DONGKHOA/SMART_LED_CONTROL/Hardware/BTL_ESD/BTL_ESD.kicad_pcb

## KiCad design Hardware/BTL_ESD/BTL_ESD.kicad_pcb (2024-05-07)

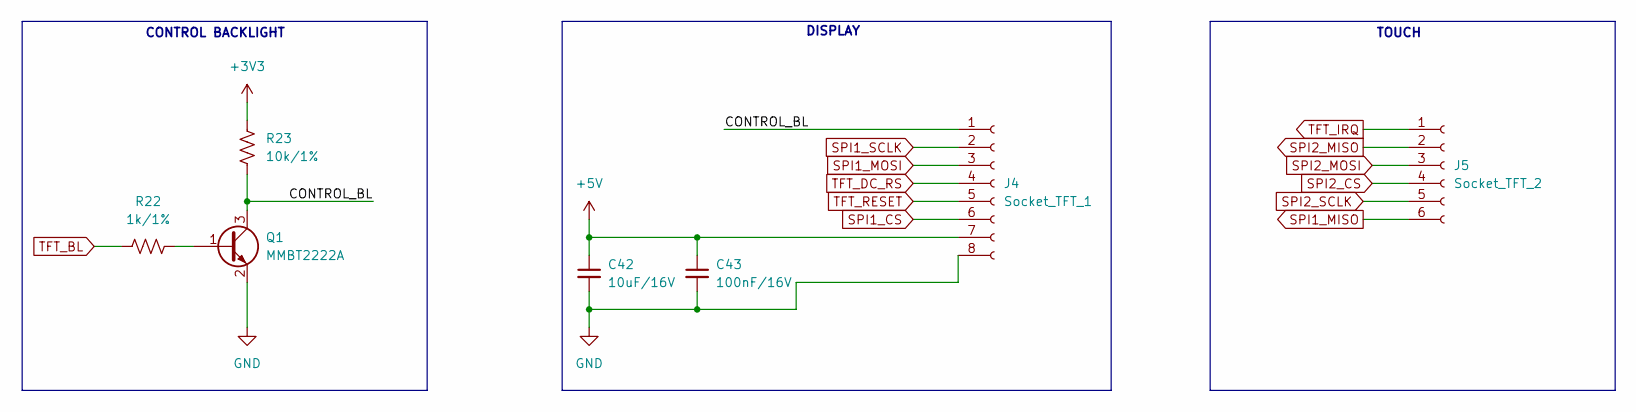
[picture p1: schematic tft.kicad_sch, ILI9341]

Parts:
C42: 10uF/16V; C_0603_1608Metric_Pad1.08x0.95mm_HandSolder
C43: 100nF/16V; C_0603_1608Metric_Pad1.08x0.95mm_HandSolder
J4: Socket_TFT_1; au_XH_2.54mm_8_Chan_Dan_SMD_Nam_Ngang
J5: Socket_TFT_2; au_XH_2.54mm_6_Chan_Dan_SMD_Nam_Ngang
Q1: MMBT2222A; SOT103P240X110-3N
R22: 1k/1%; R_0603_1608Metric_Pad0.98x0.95mm_HandSolder
R23: 10k/1%; R_0603_1608Metric_Pad0.98x0.95mm_HandSolder

Connections:
+3V3: R23.1; also elsewhere on the board
+5V: C42.1, C43.1, J4.7; also elsewhere on the board
/TFT/CONTROL_BL: J4.1, Q1.3, R23.2
GND: C42.2, C43.2, J4.8, Q1.2; also elsewhere on the board
unnamed: Q1.1, R22.2
SPI1_CS: J4.6; also elsewhere on the board
SPI1_MISO: J5.6; also elsewhere on the board
SPI1_MOSI: J4.3; also elsewhere on the board
SPI1_SCLK: J4.2; also elsewhere on the board
SPI2_CS: J5.4; also elsewhere on the board
SPI2_MISO: J5.2; also elsewhere on the board
SPI2_MOSI: J5.3; also elsewhere on the board
SPI2_SCLK: J5.5; also elsewhere on the board
TFT_BL: R22.1; also elsewhere on the board
TFT_DC_RS: J4.4; also elsewhere on the board
TFT_IRQ: J5.1; also elsewhere on the board
TFT_RESET: J4.5; also elsewhere on the board

Notes on the sheet:
TOUCH
DISPLAY
CONTROL BACKLIGHT

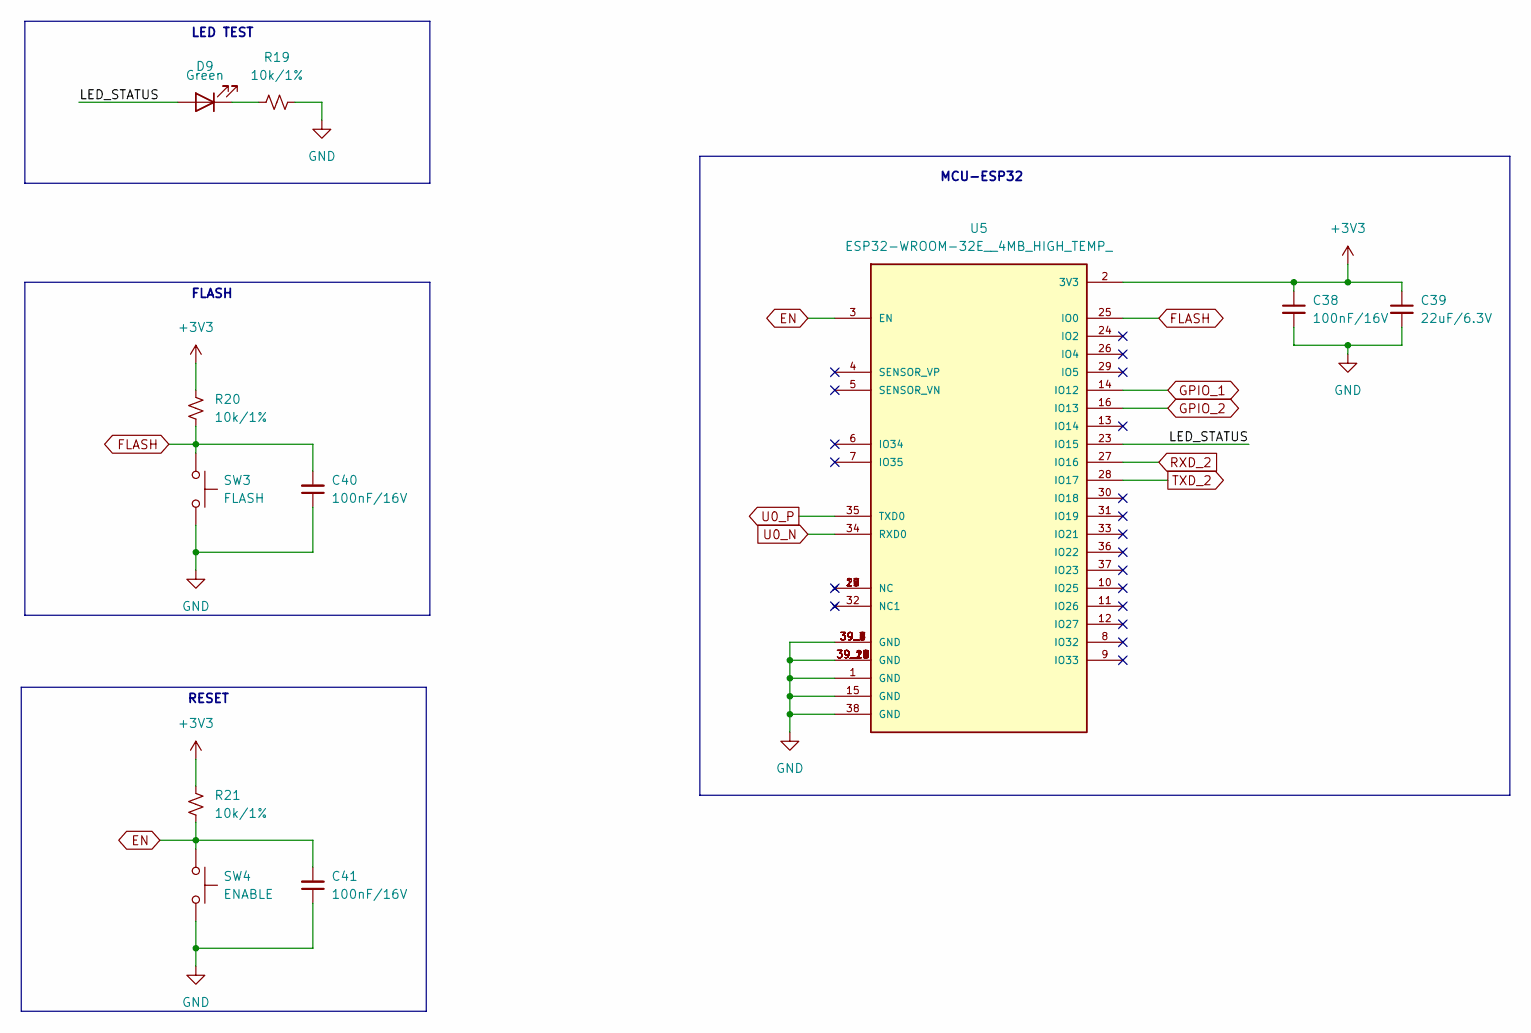
[picture p2: schematic esp32.kicad_sch]

Parts:
C38, C40, C41: 100nF/16V; C_0603_1608Metric_Pad1.08x0.95mm_HandSolder
C39: 22uF/6.3V; C_0603_1608Metric_Pad1.08x0.95mm_HandSolder
D9: Green; LED_0805_2012Metric_Pad1.15x1.40mm_HandSolder
R19, R20, R21: 10k/1%; R_0603_1608Metric_Pad0.98x0.95mm_HandSolder
SW3: FLASH; SW_SPST_B3U-1000P
SW4: ENABLE; SW_SPST_B3U-1000P
U5: ESP32-WROOM-32E__4MB_HIGH_TEMP_; XCVR_ESP32-WROOM-32E__4MB_HIGH_TEMP_

Connections:
+3V3: C38.1, C39.1, R20.1, R21.1, U5.2 (3V3); also elsewhere on the board
/ESP32/LED_STATUS: D9.2 (A), U5.23 (IO15)
EN: C41.2, R21.2, SW4.1, U5.3 (EN); also elsewhere on the board
FLASH: C40.2, R20.2, SW3.1, U5.25 (IO0); also elsewhere on the board
GND: C38.2, C39.2, C40.1, C41.1, R19.2, SW3.2, SW4.2, U5.1 (GND), U5.15 (GND), U5.38 (GND), U5.39_1 (GND), U5.39_2 (GND), U5.39_3 (GND), U5.39_4 (GND), U5.39_5 (GND), U5.39_6 (GND), U5.39_7 (GND), U5.39_8 (GND), U5.39_9 (GND), U5.39_10 (GND), U5.39_11 (GND), U5.39_12 (GND), U5.39_13 (GND), U5.39_14 (GND), U5.39_15 (GND), U5.39_16 (GND), U5.39_17 (GND), U5.39_18 (GND), U5.39_19 (GND), U5.39_20 (GND), U5.39_21 (GND); also elsewhere on the board
GPIO_1: U5.14 (IO12); also elsewhere on the board
GPIO_2: U5.16 (IO13); also elsewhere on the board
unnamed: D9.1 (K), R19.1
RXD_2: U5.27 (IO16); also elsewhere on the board
TXD_2: U5.28 (IO17); also elsewhere on the board
U0_N: U5.34 (RXD0); also elsewhere on the board
U0_P: U5.35 (TXD0); also elsewhere on the board

Notes on the sheet:
MCU-ESP32
LED TEST
RESET
FLASH

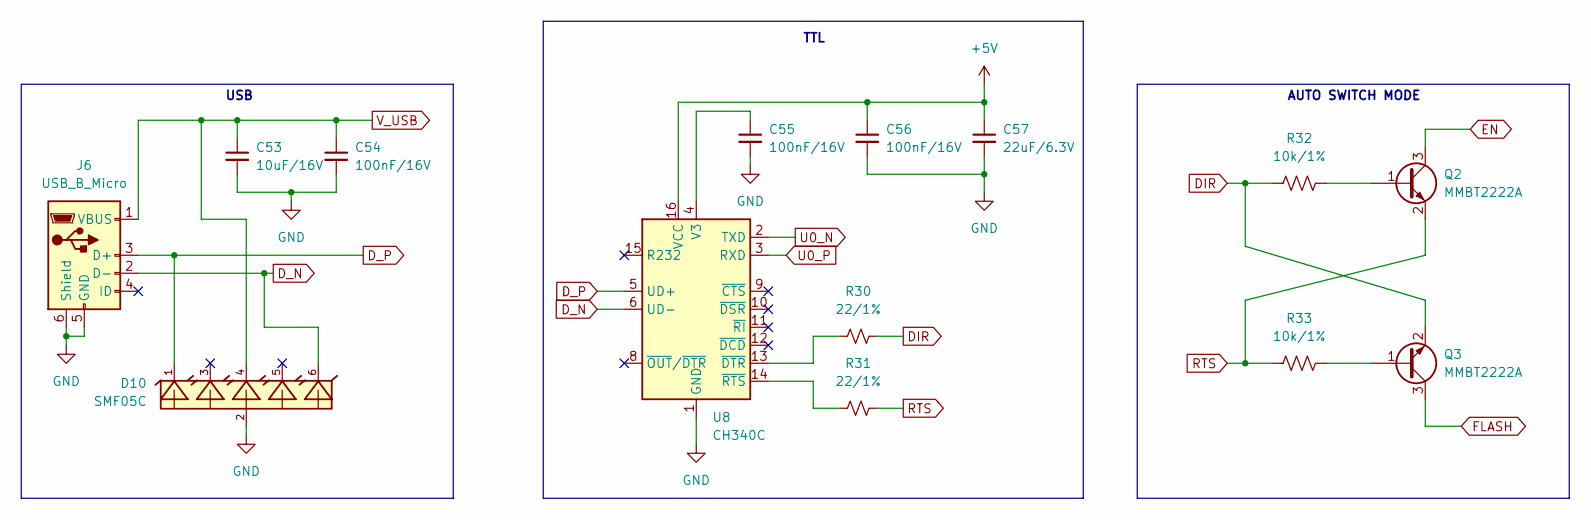
[picture p3: schematic USB_TTL.kicad_sch]

Parts:
C53: 10uF/16V; C_0603_1608Metric_Pad1.08x0.95mm_HandSolder
C54, C55, C56: 100nF/16V; C_0603_1608Metric_Pad1.08x0.95mm_HandSolder
C57: 22uF/6.3V; C_0603_1608Metric_Pad1.08x0.95mm_HandSolder
D10: SMF05C; SC70-6
J6: USB_B_Micro; USB_Micro-B_Wuerth_629105150521
Q2, Q3: MMBT2222A; SOT103P240X110-3N
R30, R31: 22/1%; R_0603_1608Metric_Pad0.98x0.95mm_HandSolder
R32, R33: 10k/1%; R_0603_1608Metric_Pad0.98x0.95mm_HandSolder
U8: CH340C; SOIC-16_3.9x9.9mm_P1.27mm

Connections:
+5V: C56.1, C57.1, U8.16 (VCC); also elsewhere on the board
DIR: Q3.2, R30.2, R32.1
D_N: D10.6, J6.2 (D-), U8.6 (UD-)
D_P: D10.1, J6.3 (D+), U8.5 (UD+)
EN: Q2.3; also elsewhere on the board
FLASH: Q3.3; also elsewhere on the board
GND: C53.2, C54.2, C55.2, C56.2, C57.2, D10.2, J6.5 (GND), J6.6 (Shield), U8.1 (GND); also elsewhere on the board
unnamed: Q2.1, R32.2
unnamed: Q3.1, R33.2
unnamed: C55.1, U8.4 (V3)
unnamed: R30.1, U8.13 (~DTR)
unnamed: R31.1, U8.14 (~RTS)
RTS: Q2.2, R31.2, R33.1
U0_N: U8.2 (TXD); also elsewhere on the board
U0_P: U8.3 (RXD); also elsewhere on the board
V_USB: C53.1, C54.1, D10.4, J6.1 (VBUS); also elsewhere on the board

Notes on the sheet:
TTL
AUTO SWITCH MODE
USB

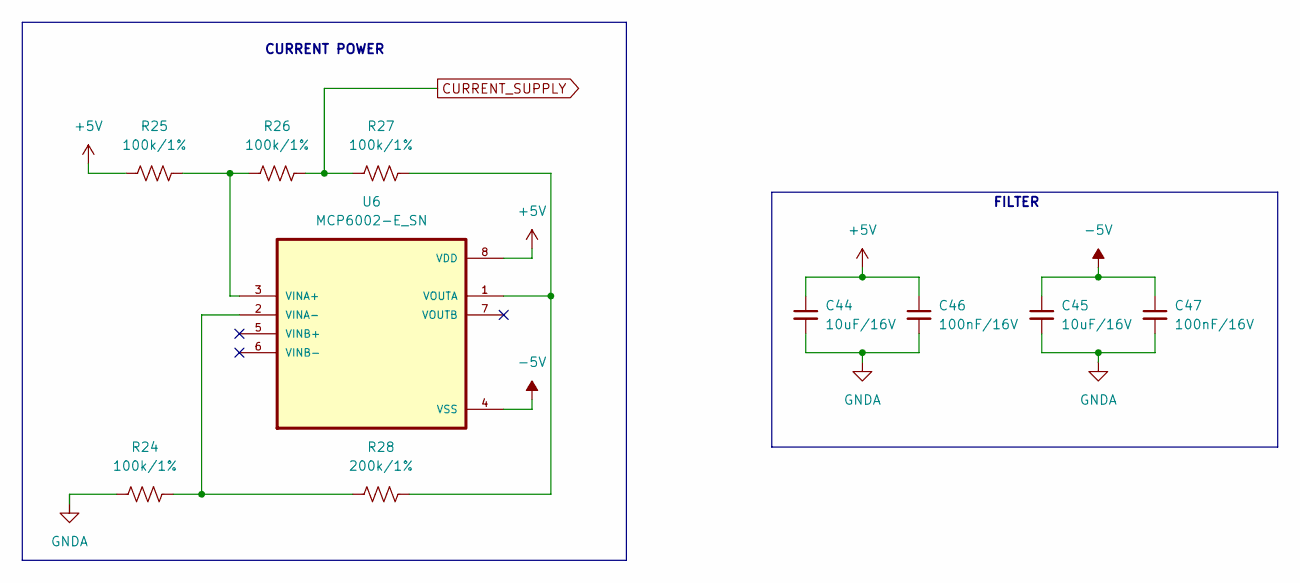
[picture p4: schematic current_supply.kicad_sch, CURRENT SUPPLY]

Parts:
C44, C45: 10uF/16V; C_0603_1608Metric_Pad1.08x0.95mm_HandSolder
C46, C47: 100nF/16V; C_0603_1608Metric_Pad1.08x0.95mm_HandSolder
R24, R25, R26, R27: 100k/1%; R_0603_1608Metric_Pad0.98x0.95mm_HandSolder
R28: 200k/1%; R_0603_1608Metric_Pad0.98x0.95mm_HandSolder
U6: MCP6002-E_SN; SOIC127P599X175-8N

Connections:
+5V: C44.1, C46.1, R25.1, U6.8 (VDD); also elsewhere on the board
-5V: C45.1, C47.1, U6.4 (VSS); also elsewhere on the board
CURRENT_SUPPLY: R26.2, R27.1; also elsewhere on the board
GNDA: C44.2, C45.2, C46.2, C47.2, R24.1; also elsewhere on the board
unnamed: R25.2, R26.1, U6.3 (VINA+)
unnamed: R24.2, R28.1, U6.2 (VINA-)
unnamed: R27.2, R28.2, U6.1 (VOUTA)

Notes on the sheet:
CURRENT POWER
FILTER

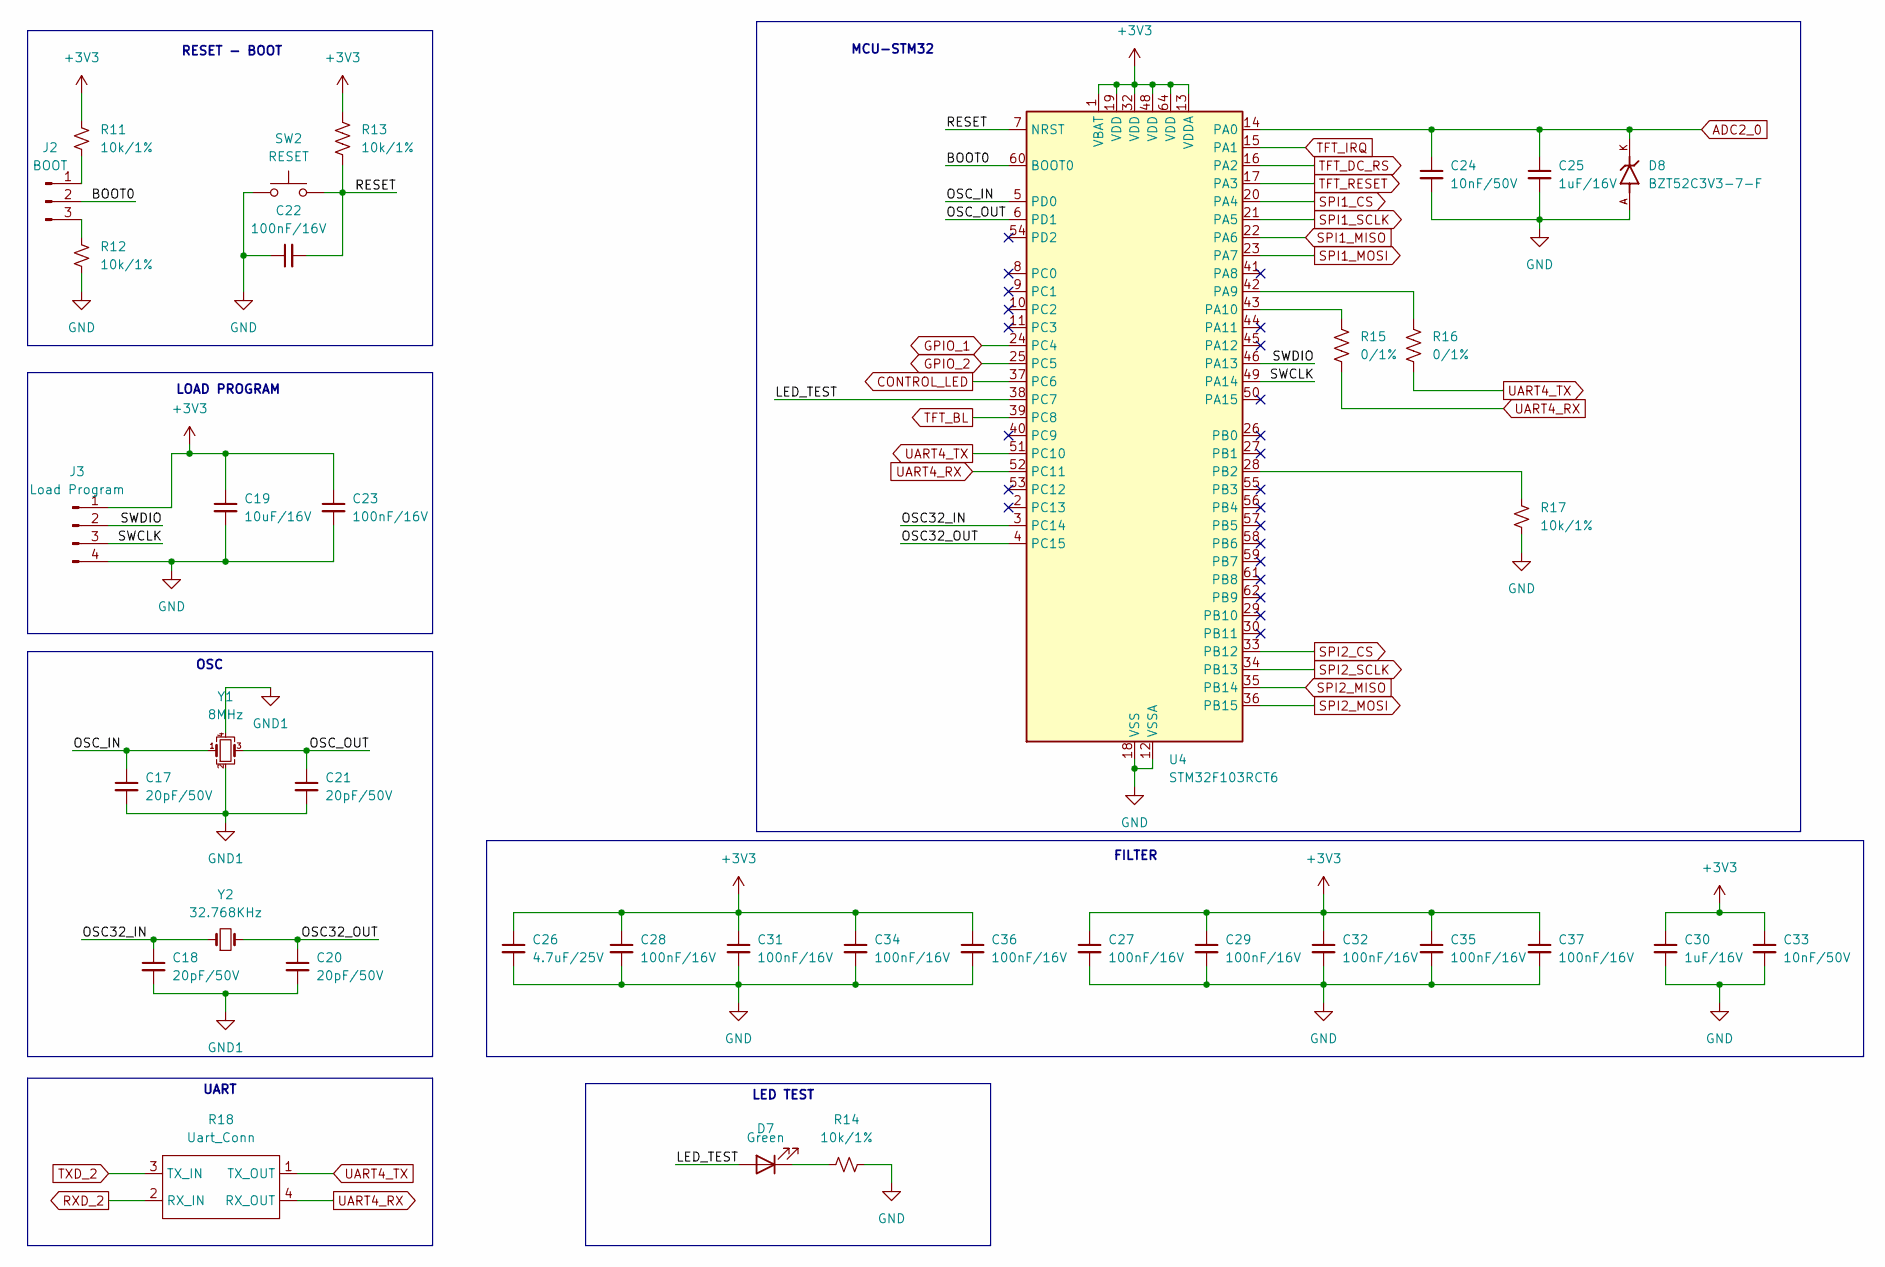
[picture p5: schematic stm32.kicad_sch]

Parts:
C17, C18, C20, C21: 20pF/50V; C_0603_1608Metric_Pad1.08x0.95mm_HandSolder
C19: 10uF/16V; C_0603_1608Metric_Pad1.08x0.95mm_HandSolder
C22, C23, C27, C28, C29, C31, C32, C34, C35, C36, C37: 100nF/16V; C_0603_1608Metric_Pad1.08x0.95mm_HandSolder
C24, C33: 10nF/50V; C_0603_1608Metric_Pad1.08x0.95mm_HandSolder
C25, C30: 1uF/16V; C_0603_1608Metric_Pad1.08x0.95mm_HandSolder
C26: 4.7uF/25V; C_0603_1608Metric_Pad1.08x0.95mm_HandSolder
D7: Green; LED_0805_2012Metric_Pad1.15x1.40mm_HandSolder
D8: BZT52C3V3-7-F; BZT52C3V3
J2: BOOT; PinHeader_1x03_P2.54mm_Vertical
J3: Load Program; PinHeader_1x04_P2.54mm_Vertical
R11, R12, R13, R14, R17: 10k/1%; R_0603_1608Metric_Pad0.98x0.95mm_HandSolder
R15, R16: 0/1%; R_0603_1608Metric_Pad0.98x0.95mm_HandSolder
R18: Uart_Conn; uart_conn
SW2: RESET; SW_SPST_B3U-1000P
U4: STM32F103RCT6; LQFP-64_10x10mm_P0.5mm
Y1: 8MHz; Crystal_SMD_EuroQuartz_MQ-4Pin_7.0x5.0mm
Y2: 32.768KHz; Crystal_SMD_3215-2Pin_3.2x1.5mm

Connections:
+3V3: C19.1, C23.1, C26.1, C27.1, C28.1, C29.1, C30.1, C31.1, C32.1, C33.1, C34.1, C35.1, C36.1, C37.1, J3.1, R11.1, R13.1, U4.1 (VBAT), U4.13 (VDDA), U4.19 (VDD), U4.32 (VDD), U4.48 (VDD), U4.64 (VDD); also elsewhere on the board
/STM32/BOOT0: J2.2, U4.60 (BOOT0)
/STM32/LED_TEST: D7.2 (A), U4.38 (PC7)
/STM32/OSC32_IN: C18.1, U4.3 (PC14), Y2.1
/STM32/OSC32_OUT: C20.1, U4.4 (PC15), Y2.2
/STM32/OSC_IN: C17.1, U4.5 (PD0), Y1.1
/STM32/OSC_OUT: C21.1, U4.6 (PD1), Y1.3
/STM32/RESET: C22.2, R13.2, SW2.2, U4.7 (NRST)
/STM32/SWCLK: J3.3, U4.49 (PA14)
/STM32/SWDIO: J3.2, U4.46 (PA13)
ADC1_0: C24.1, C25.1, D8.K, U4.14 (PA0); also elsewhere on the board
CONTROL_LED: U4.37 (PC6); also elsewhere on the board
GND: C19.2, C22.1, C23.2, C24.2, C25.2, C26.2, C27.2, C28.2, C29.2, C30.2, C31.2, C32.2, C33.2, C34.2, C35.2, C36.2, C37.2, D8.A, J3.4, R12.2, R14.2, R17.2, SW2.1, U4.12 (VSSA), U4.18 (VSS), U4.31 (VSS), U4.47 (VSS), U4.63 (VSS); also elsewhere on the board
GND1: C17.2, C18.2, C20.2, C21.2, Y1.2, Y1.4; also elsewhere on the board
GPIO_1: U4.24 (PC4); also elsewhere on the board
GPIO_2: U4.25 (PC5); also elsewhere on the board
unnamed: D7.1 (K), R14.1
unnamed: J2.1, R11.2
unnamed: J2.3, R12.1
unnamed: R16.1, U4.42 (PA9)
unnamed: R15.1, U4.43 (PA10)
unnamed: R17.1, U4.28 (PB2)
RXD_2: R18.2 (RX_IN); also elsewhere on the board
SPI1_CS: U4.20 (PA4); also elsewhere on the board
SPI1_MISO: U4.22 (PA6); also elsewhere on the board
SPI1_MOSI: U4.23 (PA7); also elsewhere on the board
SPI1_SCLK: U4.21 (PA5); also elsewhere on the board
SPI2_CS: U4.33 (PB12); also elsewhere on the board
SPI2_MISO: U4.35 (PB14); also elsewhere on the board
SPI2_MOSI: U4.36 (PB15); also elsewhere on the board
SPI2_SCLK: U4.34 (PB13); also elsewhere on the board
TFT_BL: U4.39 (PC8); also elsewhere on the board
TFT_DC_RS: U4.16 (PA2); also elsewhere on the board
TFT_IRQ: U4.15 (PA1); also elsewhere on the board
TFT_RESET: U4.17 (PA3); also elsewhere on the board
TXD_2: R18.3 (TX_IN); also elsewhere on the board
UART4_RX: R15.2, R18.4 (RX_OUT), U4.52 (PC11)
UART4_TX: R16.2, R18.1 (TX_OUT), U4.51 (PC10)

Notes on the sheet:
UART
MCU-STM32
FILTER
OSC
RESET - BOOT
LOAD PROGRAM
LED TEST

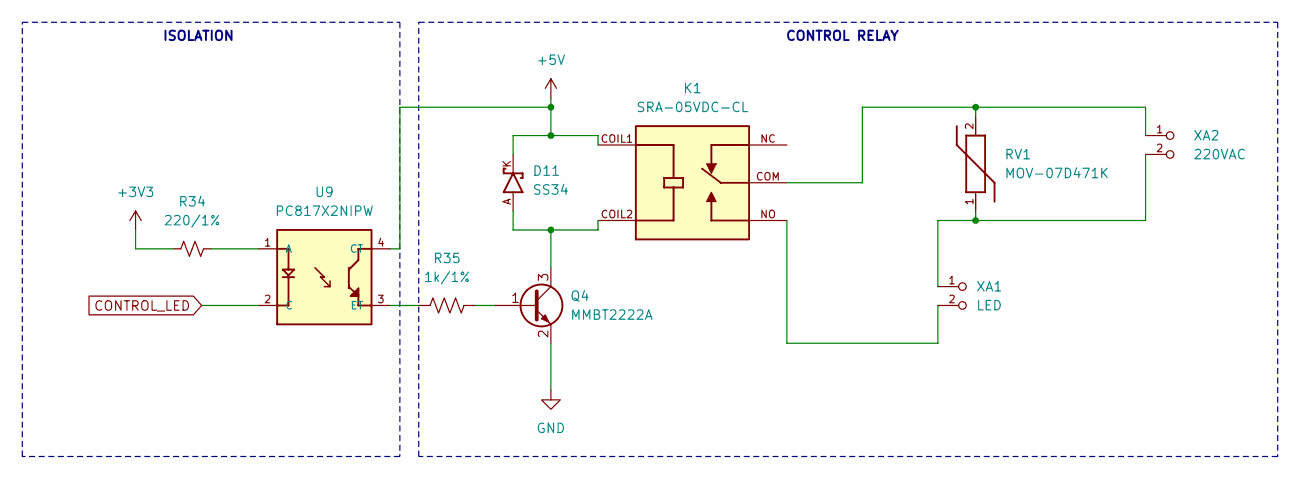
[picture p6: schematic control_led.kicad_sch, CONTROL LED]

Parts:
D11: SS34; DO-214AC
K1: SRA-05VDC-CL; RELAY_SRA-05VDC-CL
Q4: MMBT2222A; SOT103P240X110-3N
R34: 220/1%; R_0603_1608Metric_Pad0.98x0.95mm_HandSolder
R35: 1k/1%; R_0603_1608Metric_Pad0.98x0.95mm_HandSolder
RV1: MOV-07D471K; MOV07D471K
U9: PC817X2NIPW; SOT254P975X400-4N
XA1: LED; PHOENIX_MKDS1_2-3.81
XA2: 220VAC; PHOENIX_MKDS1_2-3.81

Connections:
+3V3: R34.1; also elsewhere on the board
+5V: D11.K, K1.COIL1, U9.4 (CT); also elsewhere on the board
CONTROL_LED: U9.2 (C); also elsewhere on the board
GND: Q4.2; also elsewhere on the board
unnamed: D11.A, K1.COIL2, Q4.3
unnamed: K1.COM, RV1.2, XA2.1
unnamed: K1.NO, XA1.2
unnamed: Q4.1, R35.2
unnamed: RV1.1, XA1.1, XA2.2
unnamed: R34.2, U9.1 (A)
unnamed: R35.1, U9.3 (ET)

Notes on the sheet:
ISOLATION
CONTROL RELAY

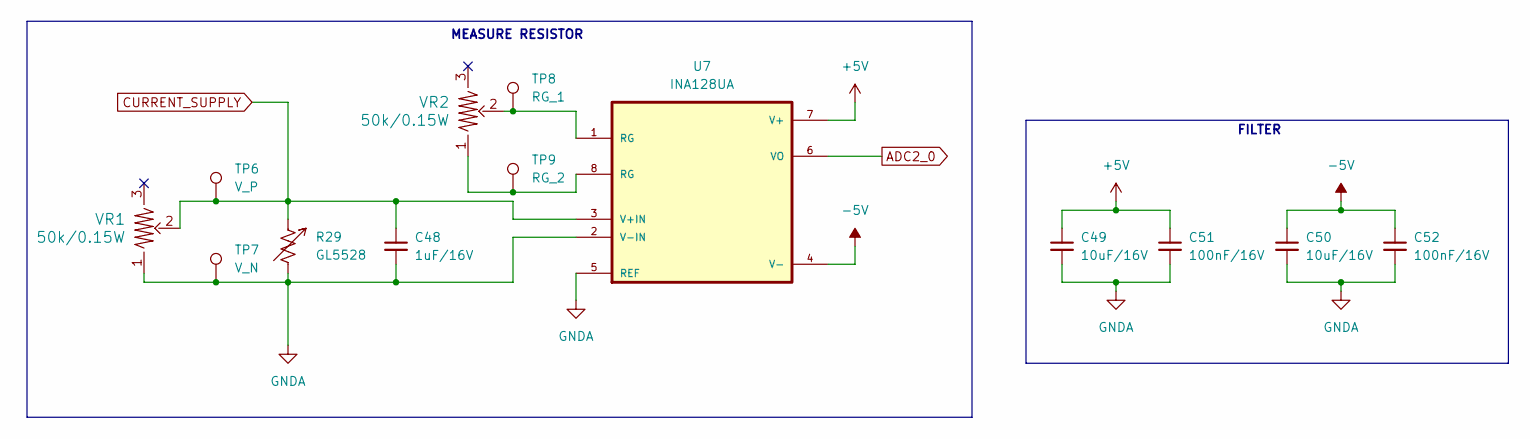
[picture p7: schematic measure.kicad_sch]

Parts:
C48: 1uF/16V; C_0603_1608Metric_Pad1.08x0.95mm_HandSolder
C49, C50: 10uF/16V; C_0603_1608Metric_Pad1.08x0.95mm_HandSolder
C51, C52: 100nF/16V; C_0603_1608Metric_Pad1.08x0.95mm_HandSolder
R29: GL5528; R_LDR_5.0x4.1mm_P3mm_Vertical
TP6: V_P; TestPoint_Pad_D2.5mm
TP7: V_N; TestPoint_Pad_D2.5mm
TP8: RG_1; TestPoint_Pad_D2.5mm
TP9: RG_2; TestPoint_Pad_D2.5mm
U7: INA128UA; SOIC127P599X175-8N
VR1, VR2: 50k/0.15W; EVM-3E

Connections:
+5V: C49.1, C51.1, U7.7 (V+); also elsewhere on the board
-5V: C50.1, C52.1, U7.4 (V-); also elsewhere on the board
ADC1_0: U7.6 (VO); also elsewhere on the board
CURRENT_SUPPLY: C48.1, R29.1, TP6.1, U7.3 (V+IN), VR1.2; also elsewhere on the board
GNDA: C48.2, C49.2, C50.2, C51.2, C52.2, R29.2, TP7.1, U7.2 (V-IN), U7.5 (REF), VR1.1; also elsewhere on the board
unnamed: TP8.1, U7.1 (RG), VR2.2
unnamed: TP9.1, U7.8 (RG), VR2.1

Notes on the sheet:
MEASURE RESISTOR
FILTER

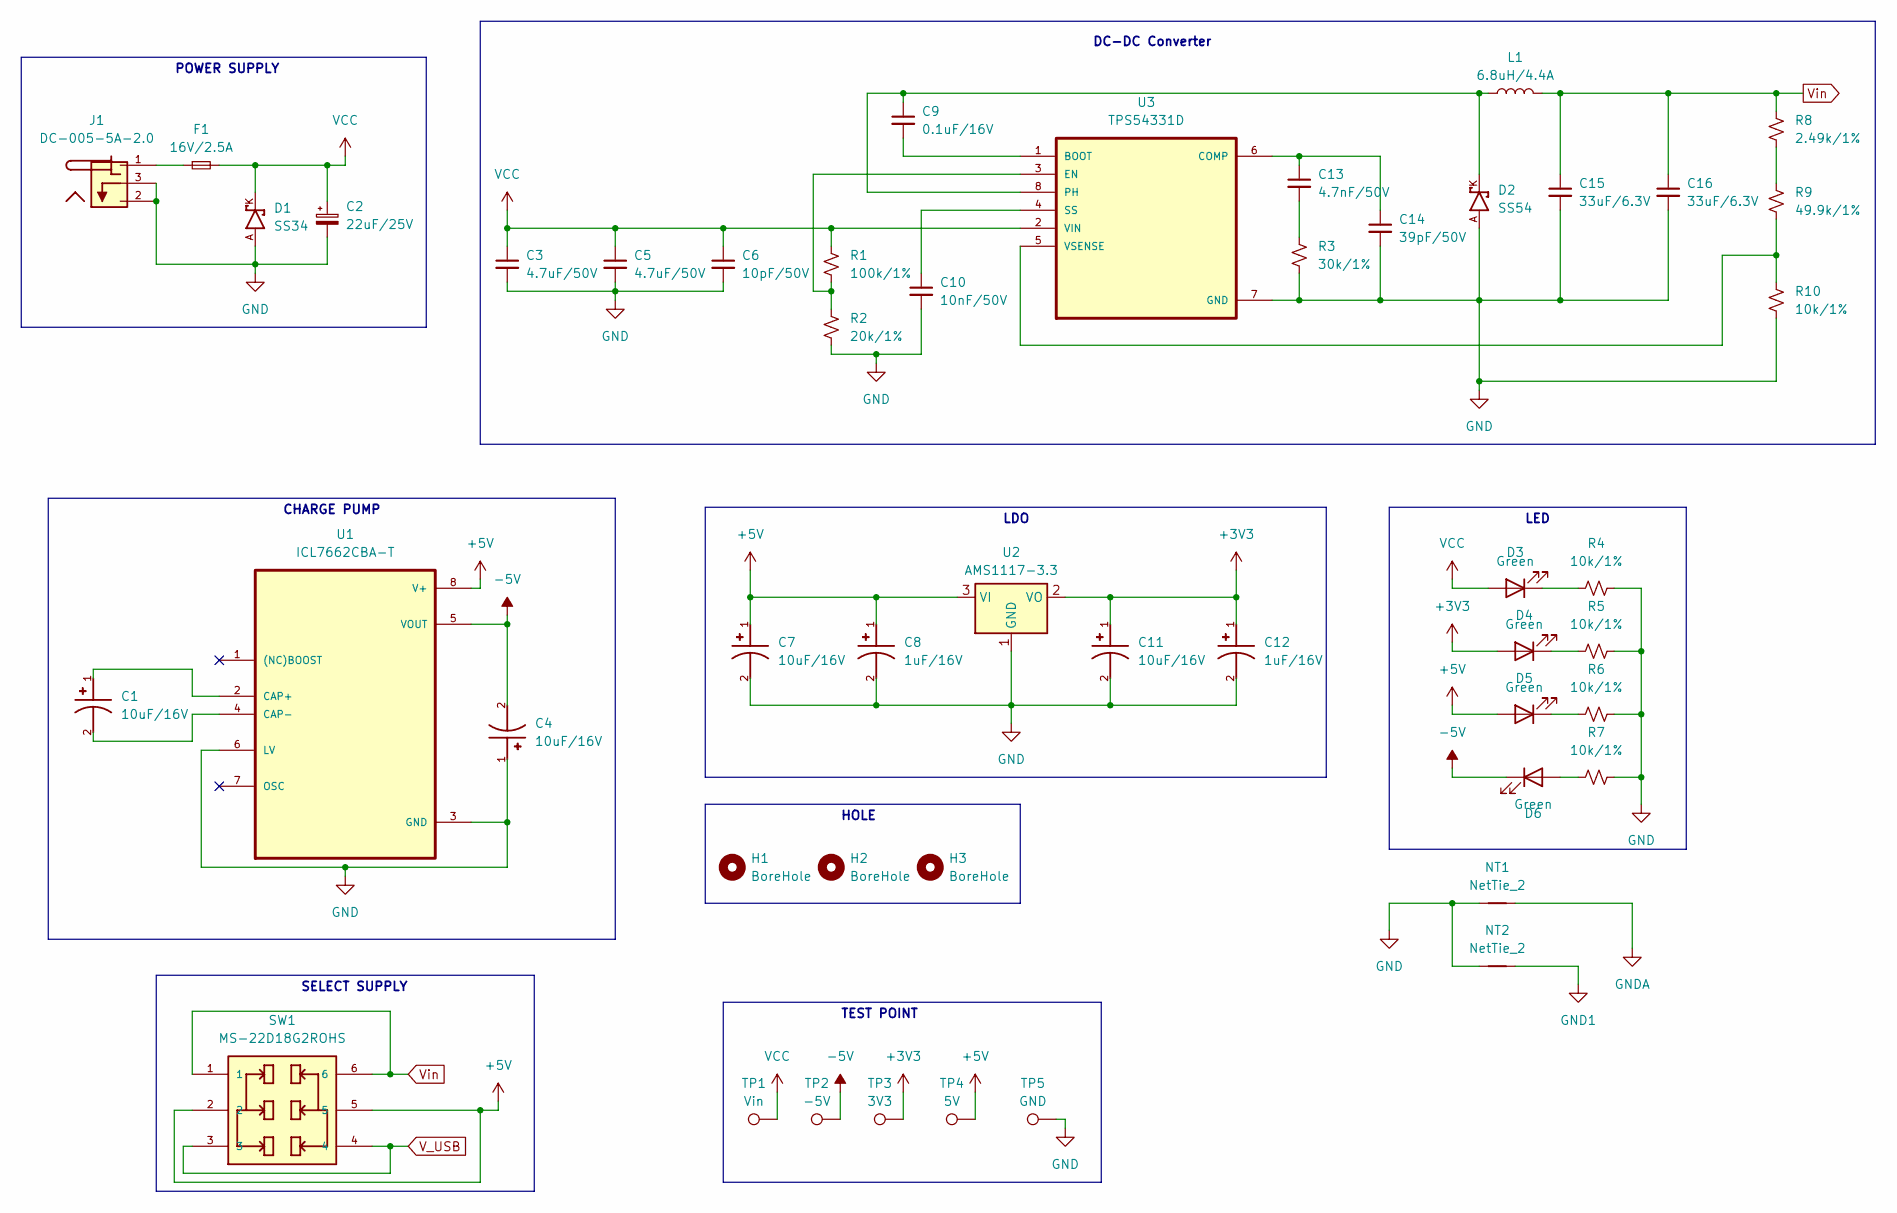
[picture p8: schematic power_supply.kicad_sch, POWER SUPPLY]

Parts:
C1, C4, C7, C11: 10uF/16V; CAPMP3216X180N
C2: 22uF/25V; CP_Elec_6.3x5.4
C3, C5: 4.7uF/50V; C_0805_2012Metric_Pad1.18x1.45mm_HandSolder
C6: 10pF/50V; C_0805_2012Metric_Pad1.18x1.45mm_HandSolder
C8, C12: 1uF/16V; CAPMP3216X180N
C9: 0.1uF/16V; C_0603_1608Metric_Pad1.08x0.95mm_HandSolder
C10: 10nF/50V; C_0603_1608Metric_Pad1.08x0.95mm_HandSolder
C13: 4.7nF/50V; C_0603_1608Metric_Pad1.08x0.95mm_HandSolder
C14: 39pF/50V; C_0603_1608Metric_Pad1.08x0.95mm_HandSolder
C15, C16: 33uF/6.3V; C_0805_2012Metric_Pad1.18x1.45mm_HandSolder
D1: SS34; DO-214AC
D2: SS54; DO-214AC
D3, D4, D5, D6: Green; LED_0805_2012Metric_Pad1.15x1.40mm_HandSolder
F1: 16V/2.5A; Fuse_1812_4532Metric_Pad1.30x3.40mm_HandSolder
H1, H2, H3: BoreHole; MountingHole_3.2mm_M3_Pad_TopBottom
J1: DC-005-5A-2.0; XKB_DC-005-5A-2.0
L1: 6.8uH/4.4A; CDRH8D43NP-6R8
NT1: NetTie_2; NetTie-2_SMD_Pad2.0mm
NT2: NetTie_2; NetTie-2_SMD_Pad0.5mm
R1: 100k/1%; R_0603_1608Metric_Pad0.98x0.95mm_HandSolder
R2: 20k/1%; R_0603_1608Metric_Pad0.98x0.95mm_HandSolder
R3: 30k/1%; R_0603_1608Metric_Pad0.98x0.95mm_HandSolder
R4, R5, R6, R7, R10: 10k/1%; R_0603_1608Metric_Pad0.98x0.95mm_HandSolder
R8: 2.49k/1%; R_0603_1608Metric_Pad0.98x0.95mm_HandSolder
R9: 49.9k/1%; R_0603_1608Metric_Pad0.98x0.95mm_HandSolder
SW1: MS-22D18G2ROHS; SW_MS-22D18G2ROHS
TP1: Vin; TestPoint_Pad_D2.5mm
TP2: -5V; TestPoint_Pad_D2.5mm
TP3: 3V3; TestPoint_Pad_D2.5mm
TP4: 5V; TestPoint_Pad_D2.5mm
TP5: GND; TestPoint_Pad_D2.5mm
U1: ICL7662CBA-T; SOIC127P600X175-8N
U2: AMS1117-3.3; SOT-223-3_TabPin2
U3: TPS54331D; SOIC127P599X175-8N

Connections:
+3V3: C11.1, C12.1, D4.2 (A), TP3.1, U2.2 (VO); also elsewhere on the board
+5V: C7.1, C8.1, D5.2 (A), SW1.2, SW1.5, TP4.1, U1.8 (V+), U2.3 (VI); also elsewhere on the board
-5V: C4.2, D6.1 (K), TP2.1, U1.5 (VOUT); also elsewhere on the board
GND: C2.2, C3.2, C4.1, C5.2, C6.2, C7.2, C8.2, C10.2, C11.2, C12.2, C14.2, C15.2, C16.2, D1.A, D2.A, J1.2, J1.3, NT1.1, NT2.1, R2.2, R3.2, R4.2, R5.2, R6.2, R7.2, R10.2, TP5.1, U1.3 (GND), U1.6 (LV), U2.1 (GND), U3.7 (GND); also elsewhere on the board
GND1: NT2.2; also elsewhere on the board
GNDA: NT1.2; also elsewhere on the board
unnamed: C13.2, R3.1
unnamed: D3.1 (K), R4.1
unnamed: D4.1 (K), R5.1
unnamed: D5.1 (K), R6.1
unnamed: D6.2 (A), R7.1
unnamed: F1.1, J1.1
unnamed: R8.2, R9.1
unnamed: C1.1, U1.2 (CAP+)
unnamed: C1.2, U1.4 (CAP-)
unnamed: C9.2, U3.1 (BOOT)
unnamed: C13.1, C14.1, U3.6 (COMP)
unnamed: R1.2, R2.1, U3.3 (EN)
unnamed: C9.1, D2.K, L1.1, U3.8 (PH)
unnamed: C10.1, U3.4 (SS)
unnamed: R9.2, R10.1, U3.5 (VSENSE)
VCC: C2.1, C3.1, C5.1, C6.1, D1.K, D3.2 (A), F1.2, R1.1, TP1.1, U3.2 (VIN)
V_USB: SW1.3, SW1.4; also elsewhere on the board
Vin: C15.1, C16.1, L1.2, R8.1, SW1.1, SW1.6

Notes on the sheet:
DC-DC Converter
CHARGE PUMP
SELECT SUPPLY
LDO
HOLE
POWER SUPPLY
TEST POINT
LED

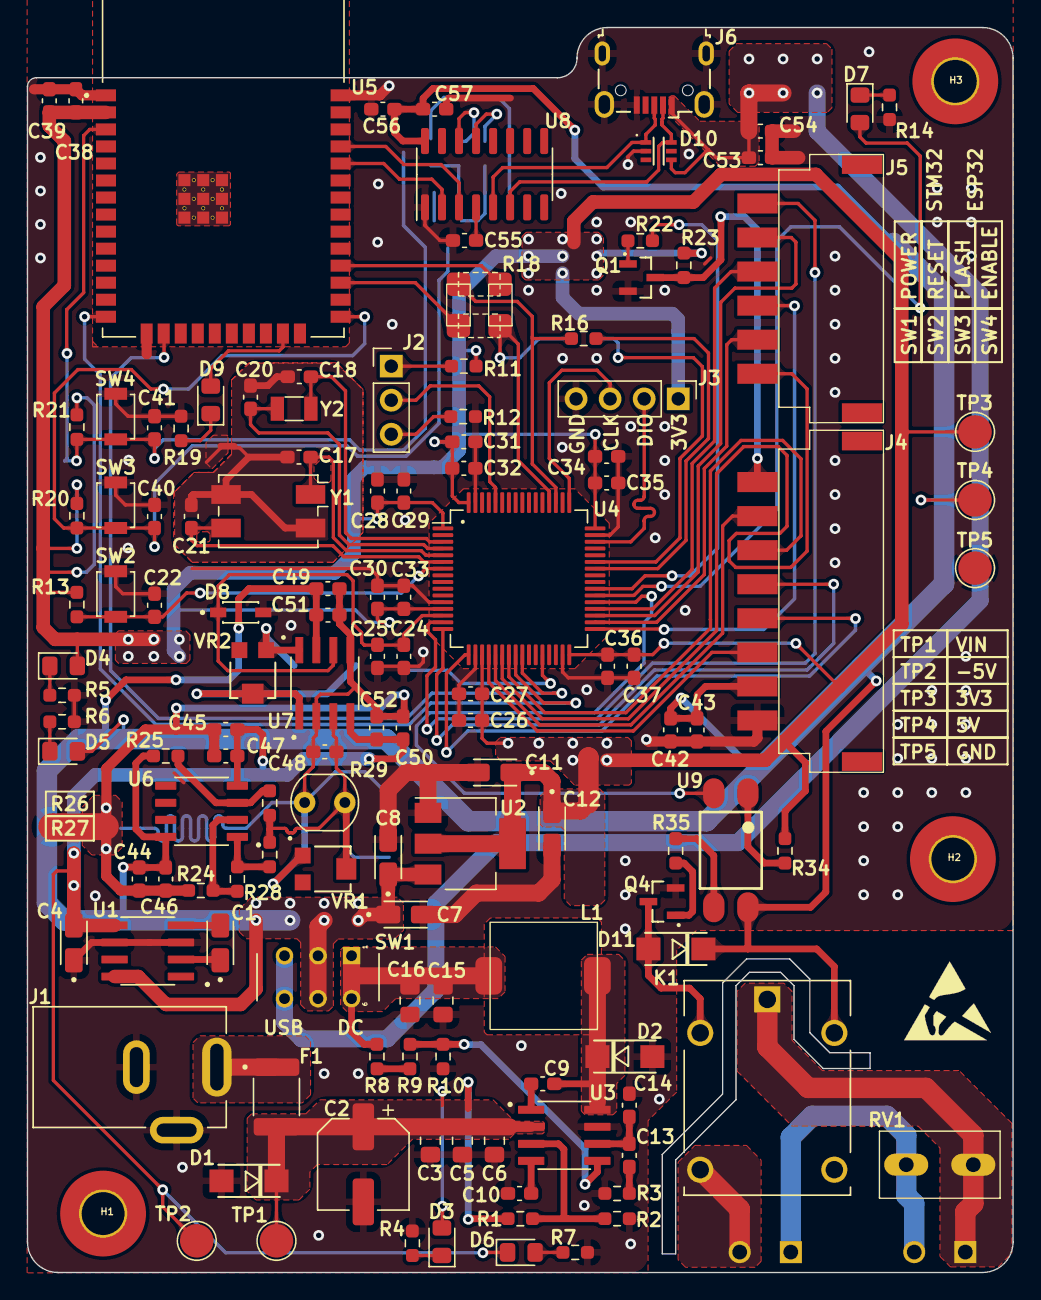
[picture p9: board BTL_ESD.kicad_pcb from above]

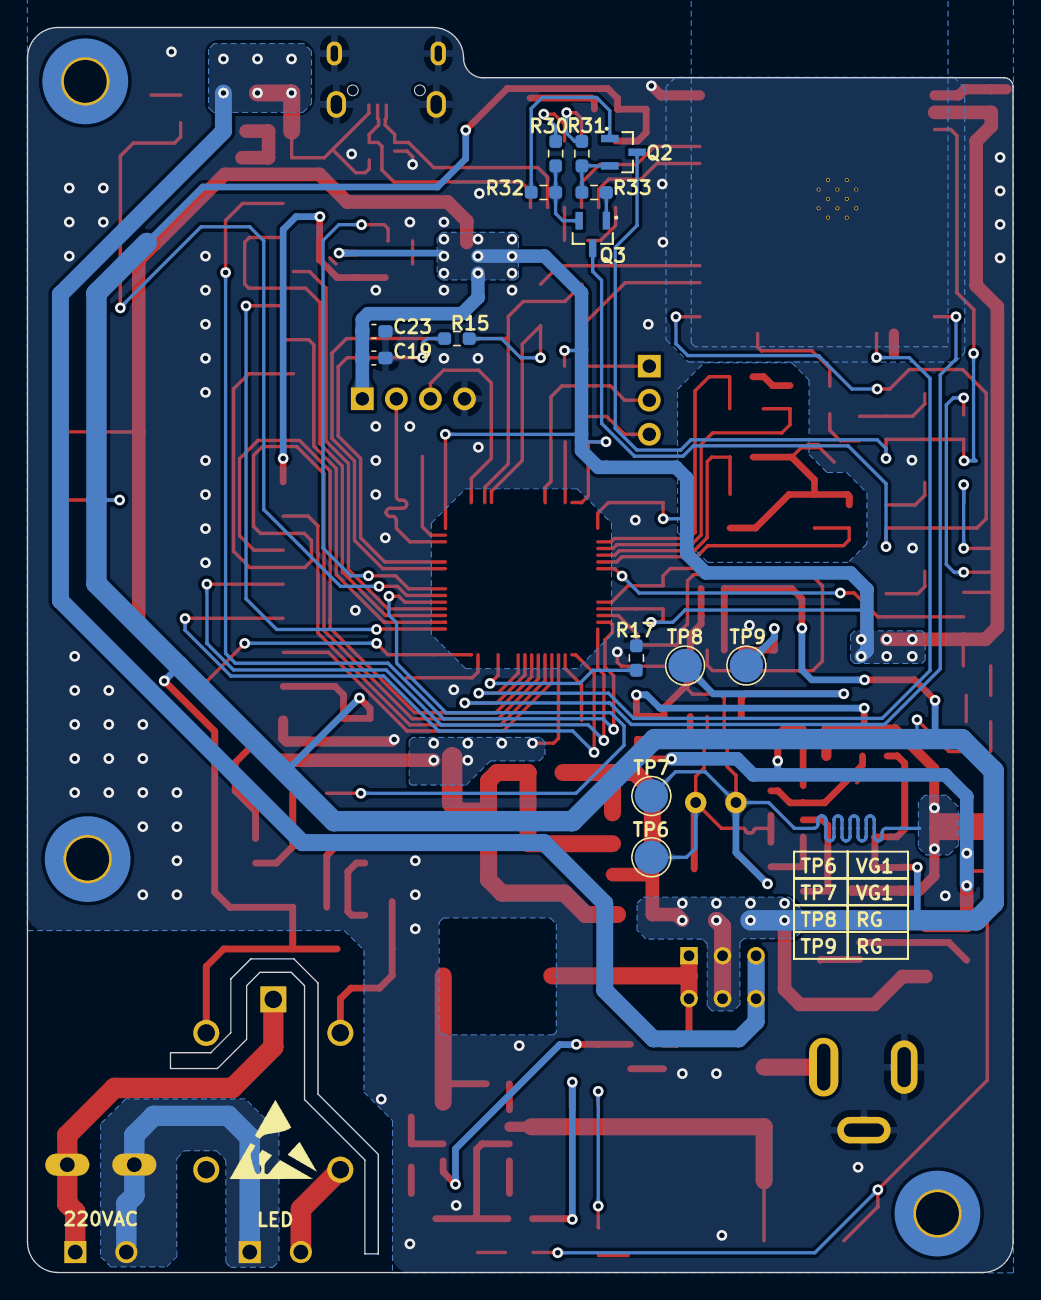
[picture p10: board BTL_ESD.kicad_pcb from below]

Board: 2 copper layers, 73.5 x 92.8 mm, 150 parts (14 on the bottom side), 89 nets.
