DONGKHOA/SMART_LED_CONTROL/Firmware/STM32/BLT_ESD.ioc

Mcu.UserName=STM32F103RCTx
PA0-WKUP.Signal=ADCx_IN0
PA1.Signal=GPIO_Input
PA13.Signal=SYS_JTMS-SWDIO
PA14.Signal=SYS_JTCK-SWCLK
PA2.GPIO_Label=TFT_DC_RS
PA2.Signal=GPIO_Output
PA3.GPIO_Label=TFT_RESET
PA3.Signal=GPIO_Output
PA4.Signal=SPI1_NSS
PA5.Signal=SPI1_SCK
PA6.Signal=SPI1_MISO
PA7.Signal=SPI1_MOSI
PB12.Signal=SPI2_NSS
PB13.Signal=SPI2_SCK
PB14.Signal=SPI2_MISO
PB15.Signal=SPI2_MOSI
PC10.Signal=UART4_TX
PC11.Signal=UART4_RX
PC6.Signal=GPIO_Output
PC7.Signal=GPIO_Output
PC8.Signal=GPIO_Output
PD0-OSC_IN.Signal=RCC_OSC_IN
PD1-OSC_OUT.Signal=RCC_OSC_OUT
