DONGKHOA/SMART_LED_CONTROL/Firmware/STM32/Core/Inc/main.h

#define TFT_DC_RS_Pin GPIO_PIN_2
#define TFT_DC_RS_GPIO_Port GPIOA
#define TFT_RESET_Pin GPIO_PIN_3
#define TFT_RESET_GPIO_Port GPIOA
#define RX_BUFFER_SIZE 					          100
#define TIME_REQUEST_SCAN                 5000
#define TIME_REFRESH_DISPLAY              50
#define TIME_WAIT                         30000
#define TIME_READ						    5000
#define RESET_COORDINATE                  1000
#define ON_WIFI_BIT                       (1 << 0)
#define OFF_WIFI_BIT                      (1 << 1)
#define NEXT_PAGE_BIT						(1 << 2)
#define BACK_PAGE_BIT						(1 << 3)
#define CONNECT_WIFI_BIT                 	(1 << 4)
#define CONNECT_MQTT_BIT                 	(1 << 5)
#define MQTT_PUBLISH_BIT                 	(1 << 6)
#define SCAN_WIFI_BIT						(1 << 0)
#define CONNECT_WIFI_SUCCESSFUL_BIT       (1 << 2)
#define CONNECT_WIFI_UNSUCCESSFUL_BIT     (1 << 3)
#define REFUSE_CONNECT_MQTT_BIT           (1 << 4) // if haven't connect wifi
#define CONNECT_MQTT_SUCCESSFUL_BIT       (1 << 5)
#define CONNECT_MQTT_UNSUCCESSFUL_BIT     (1 << 6)
#define MQTT_SUBSCRIBE_BIT                (1 << 7)
#define REFRESH_DISPLAY_BIT               (1 << 9)
