DONGKHOA/SMART_LED_CONTROL/(commit log)

2024-03-07 hardware:folder hardware: upload schematic power
    [BTL_ESD.kicad_pcb, BTL_ESD.kicad_sch, TTL.kicad_sch, current_supply.kicad_sch, esp32.kicad_sch, measure.kicad_sch, power_supply.kicad_sch, stm32.kicad_sch]
2024-03-09 hardware: ver 1 schematic
    [BTL_ESD.kicad_sch, TTL.kicad_sch, USB_TTL.kicad_sch, control_led.kicad_sch, current_supply.kicad_sch, esp32.kicad_sch, measure.kicad_sch, power_supply.kicad_sch]
2024-03-16 fea:STM32: upload structure fodler
    [BTL_ESD.kicad_pcb, USB_TTL.kicad_sch, control_led.kicad_sch, current_supply.kicad_sch, esp32.kicad_sch, measure.kicad_sch, power_supply.kicad_sch, stm32.kicad_sch]
2024-03-17 fix:STM32: update structure folder Libs
    [BTL_ESD.kicad_pcb]
2024-03-17 hardware:update pcb track power
    [BTL_ESD.kicad_pcb, USB_TTL.kicad_sch, control_led.kicad_sch, current_supply.kicad_sch, esp32.kicad_sch, measure.kicad_sch, power_supply.kicad_sch, stm32.kicad_sch]
2024-03-17 code:ESP32: upload project folder
2024-03-18 code:stm32:update folder
2024-03-19 file:STM32: update structure folder
    [BTL_ESD.kicad_pcb, esp32.kicad_sch]
2024-03-19 code:STM32: update structure file
2024-03-19 code:ESP32: update library wifi
2024-03-23 code:ESP32: update uart driver, main.c && hardware file pcb
    [BTL_ESD-B_Cu.gbr, BTL_ESD-B_Mask.gbr, BTL_ESD-B_Paste.gbr, BTL_ESD-B_Silkscreen.gbr, BTL_ESD-Edge_Cuts.gbr, BTL_ESD-F_Cu.gbr, BTL_ESD-F_Mask.gbr, BTL_ESD-F_Paste.gbr]
2024-03-23 code:ESP32: add comment in file .c
2024-03-24 code:ESP32: update main and structure file libs
2024-03-26 code:esp32: update main
    [BTL_ESD.csv]
2024-03-30 code:esp32:update nvs, main, wifi
2024-03-31 fea:esp32/wifi: add store wifi in nvs, scan wifi in nvs
2024-03-31 cmt:esp32: add cmt
2024-04-01 code:esp32: update typdef
2024-04-02 Doc:README:upload frame tranmission
    [power_supply.kicad_sch]
2024-04-02 code:esp32: update uart rx tx between esp32 and stm32
2024-04-04 code:README: update frame tran
2024-04-09 folder:firmware: add calib adc, adc driver, illuminance
    [BTL_ESD.kicad_pcb, BTL_ESD.kicad_sch, USB_TTL.kicad_sch, control_led.kicad_sch, current_supply.kicad_sch, esp32.kicad_sch, measure.kicad_sch, power_supply.kicad_sch]
2024-04-09 code:esp32:update main
    [BTL_ESD.kicad_pcb]
2024-04-09 code:stm32: update format code
2024-04-11 fea:stm32:add folder freertos
2024-04-13 update:esp32: name project
    [BLT_ESD Debug.cfg, BTL_ESD.kicad_sch, USB_TTL.kicad_sch, control_led.kicad_sch, current_supply.kicad_sch, esp32.kicad_sch, measure.kicad_sch, power_supply.kicad_sch]
2024-04-13 fea:stm32: add folder event ui
2024-04-13 path:stm32: add path lib ui_event and ui_screen
2024-04-14 test:esp32:scan wifi
2024-04-14 startup:stm32: update file start up
2024-04-15 Create Temperature
2024-04-16 test:esp32: fix error duplicate ssid in wifi driver
    [main.c]
2024-04-16 uart:stm32: add folder Utils from Baobuibk https://github.com/baobuibk/FreeRTOS_F4_Queue_InterTask
2024-04-16 code:esp32:update wifi driver and send frame data to stm32
2024-04-17 code:stm32:add path include
2024-04-20 code:stm32: add screen 5
2024-04-20 code:stm32:update file start up
2024-04-20 stm32: update: task_screen( add screen 5 and add icon )
2024-04-20 STM32: UI_EVENT: Update: Event_Screen_4
2024-04-21 processing data:esp32: fix uart tx and mqtt
    [main.c, main.h]
2024-04-21 STM32: Update: comment
2024-04-22 fea:stm32: update touch display
    [BLT_ESD Debug.cfg]
2024-04-22 screen2:stm32: update event
2024-04-24 update: stm32: complete icon
2024-04-24 cmt:stm32:add comment on function and variable
2024-04-25 flow system:stm32:update flow code in screen 2 and screen 3
2024-04-27 Update: STM32: completed screen_task
2024-04-28 STM32: Uart_Rx_Task
2024-04-28 update uartTx_task in main
2024-04-29 update: STM32: UartRxTask & event_screen_6
2024-04-29 update hardware
    [USB_TTL.kicad_sch, control_led.kicad_sch, current_supply.kicad_sch, esp32.kicad_sch, measure.kicad_sch, power_supply.kicad_sch, stm32.kicad_sch, tft.kicad_sch]
2024-04-29 format main.c #STM32
2024-04-29 fea:ESP32: update UART RX task
2024-04-29 fix:STM32: fix error compile
    [main.c, main.h]
2024-04-29 fix:STM32: fix error float number in line 758
    [main.c, main.h]
2024-04-30 edit variables check_state_auto/led in uartTx task and autocontrol_mode (illuminance)
2024-04-30 fix: STM32: define UartRx
    [main.c, main.h]
2024-04-30 update: UartRxTask
2024-04-30 Update: STM32: add autocontrol_mode in adc_task
2024-05-01 update timer_read_temp in ADC_task
2024-05-01 Update: STM32: move xTimerStart of timer_read_temp
2024-05-02 update:STM32:screen 1 and screen 5
2024-05-02 STM32: edit illuminance_signal()
2024-05-02 update: cordinate icon in stm32
2024-05-02 STM32: Fix illuminance_signal() in illuminance.c
2024-05-02 STM32: edit previous_state in illuminance_signal()
2024-05-05 event:stm32: update event screen 1
2024-05-05 fea:stm32: update fea auto led
2024-05-06 update esp32
2024-05-06 update screen 2 3 stm32
2024-05-07 mqtt:stm32:update flow control data
    [BTL_ESD.kicad_pcb]
2024-05-07 update: stm32: screen_screentask
2024-05-07 update reading temperature and illuminance
2024-05-07 update: stm32
2024-05-07 update stm32
2024-05-07 update: stm32:
2024-05-07 update: stm32: hardfalt
