DONGKHOA/SMART_LED_CONTROL/(notices)

Notices in the files:
Firmware/STM32/Core/Inc/main.h:
Copyright (c) 2024 STMicroelectronics.
All rights reserved.
This software is licensed under terms that can be found in the LICENSE file
